abaccin/openscad-drawer-box/(list of files, cad)

Other CAD files:
round_box_drawer.scad
