abaccin/openscad-drawer-box/(commit log)

2026-09-11 feat: publish parametric drawer box design (#1)
    [round_box_drawer.scad]
2026-09-11 feat: add lidless box stacking (#2)
    [round_box_drawer.scad]
2026-09-12 feat: add grid divisions and personal lid logo (#3)
    [round_box_drawer.scad]
2026-09-12 feat: add magnetic lids and custom text (#4)
    [round_box_drawer.scad]
2026-09-13 feat: support partial compartment sizes (#5)
    [round_box_drawer.scad]
2026-09-13 Add lid text position controls with default geometric centering (#6)
    * feat: support partial compartment sizes
    * feat: add lid text position controls
    ---------
    [round_box_drawer.scad]
2026-09-13 trying to make it work (#7)
    [round_box_drawer.scad]
2026-09-13 feat: add customizable colors and lid inlays (#8)
    Support aligned material exports for multicolor printing. Restore\nthe documented 160 x 95 x 50 defaults and original options to keep\nthe baseline configuration aligned with regression fixtures.
    [round_box_drawer.scad]
2026-09-14 Custom box 2 (#9)
    [round_box_drawer.scad]
2026-09-14 fix: isolate inlay preview rendering (#10)
    Keep F5-cached meshes out of F6 boolean unions to prevent non-manifold exports after previewing.
    [round_box_drawer.scad]
2026-09-14 feat: add aligned lid STL exporter (#11)
2026-09-14 Generate ready-assembled Bambu Studio 3MF projects (#12)
    * feat: add aligned lid STL exporter
    * feat: export ready-assembled Bambu 3MF projects
    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
2026-09-14 Include the box and decorated lid on separate 3MF print plates (#13)
    * fix: include box in two-plate 3MF projects
    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
2026-09-16 fix: restore sliding lid as default (#14)
    Restore the safe default to the original sliding lid while keeping the magnetic lid as an explicit opt-in alternative.
    This preserves the established box geometry and avoids unexpected changes for users who rely on the rail-based lid path, while still leaving the magnetic design available when requested.
    [round_box_drawer.scad]
2026-09-16 feat(sliding)!: add wraparound lid (#15)
    Match the reference's external rim and three-sided skirt while keeping
    saved dimensions and decorations.
    BREAKING CHANGE: print a matching box and lid. New sliding parts
    do not fit the previous internal-rail design. Print lids face-down.
    [round_box_drawer.scad]
2026-09-16 feat(sliding): add side grips and snap lock (#16)
    Print a matching pair for the detent. Raised grips add 1.6 mm
    to default width; face-down tabs need local supports.
    [round_box_drawer.scad]
